rickb3n/EEG32/README.md

# EEG32
Rational board for medical EEG and ECG application, based on ESP32 and ADS1118 developed as part of a DIIIE UnivAQ Electronic Systems for Mechatronics course project

###### Development Team: *Riccardo Beniamino* , *Domenico Di Nicola*

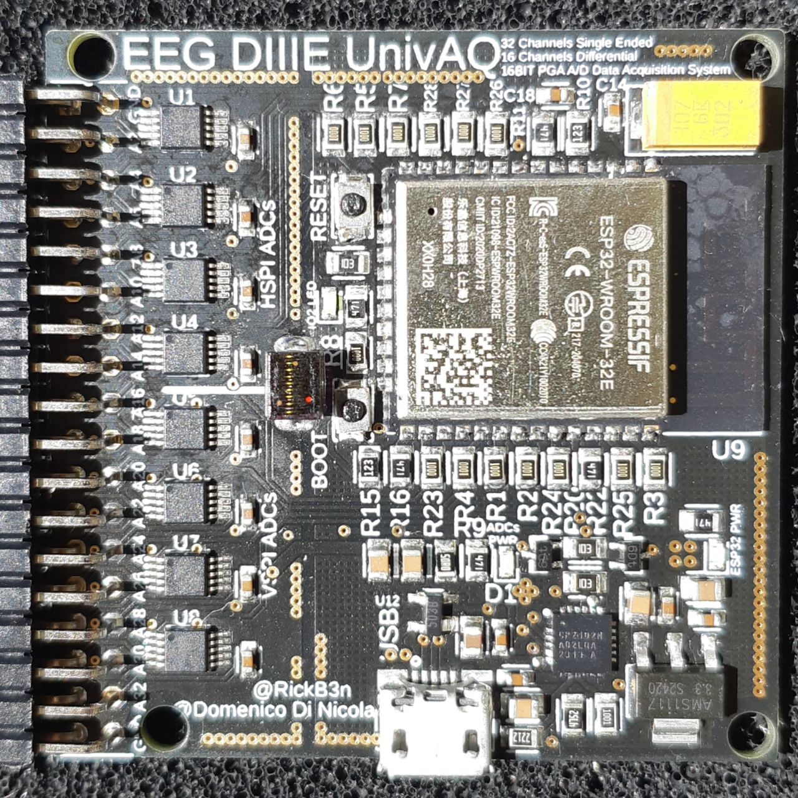
[picture p1: 1.jpg]

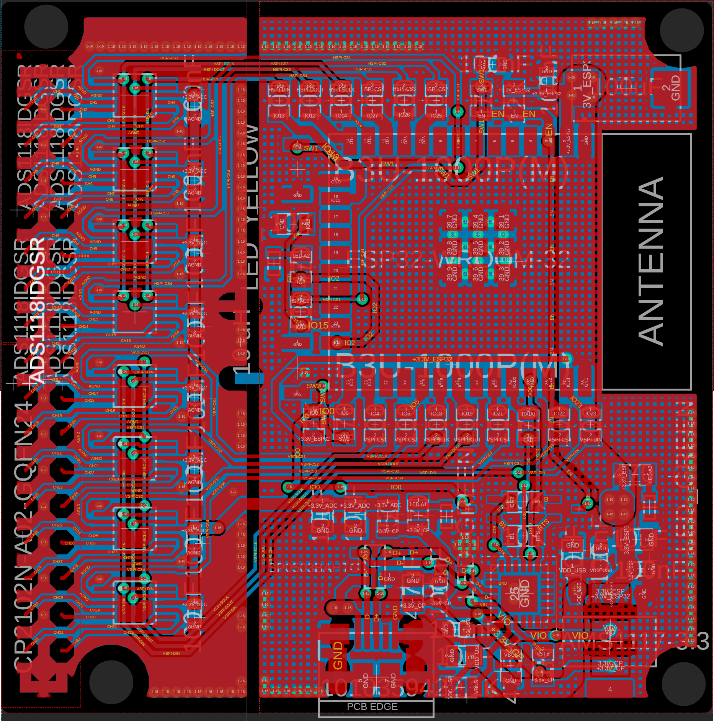
[picture p2: pcb_signals_names.png]

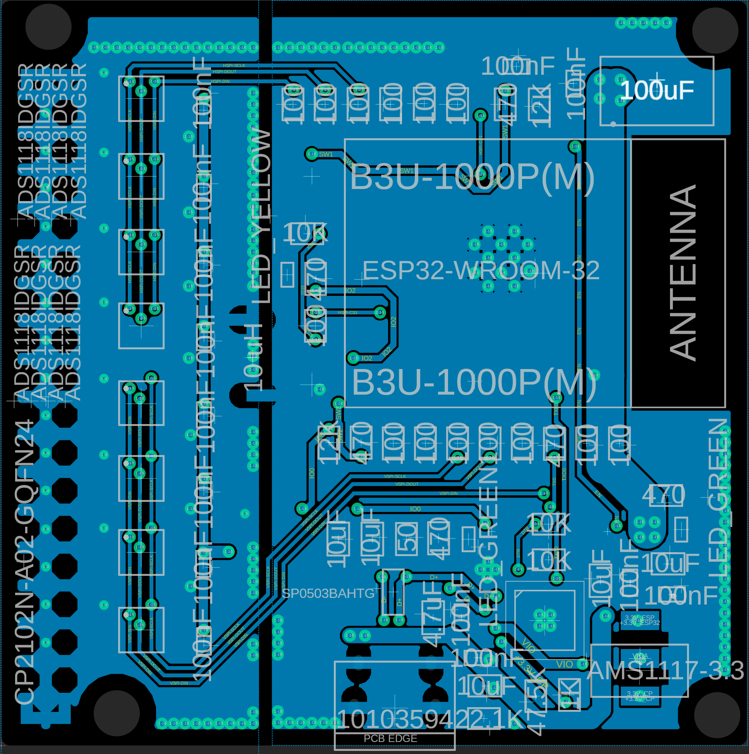
[picture p3: pcb_signals_names_back.png]
