rickb3n/EEG32/EEG32_Schematic.pdf

## ADC-CH1-4

## ADCS-CONTROLLED-BY-HSPI

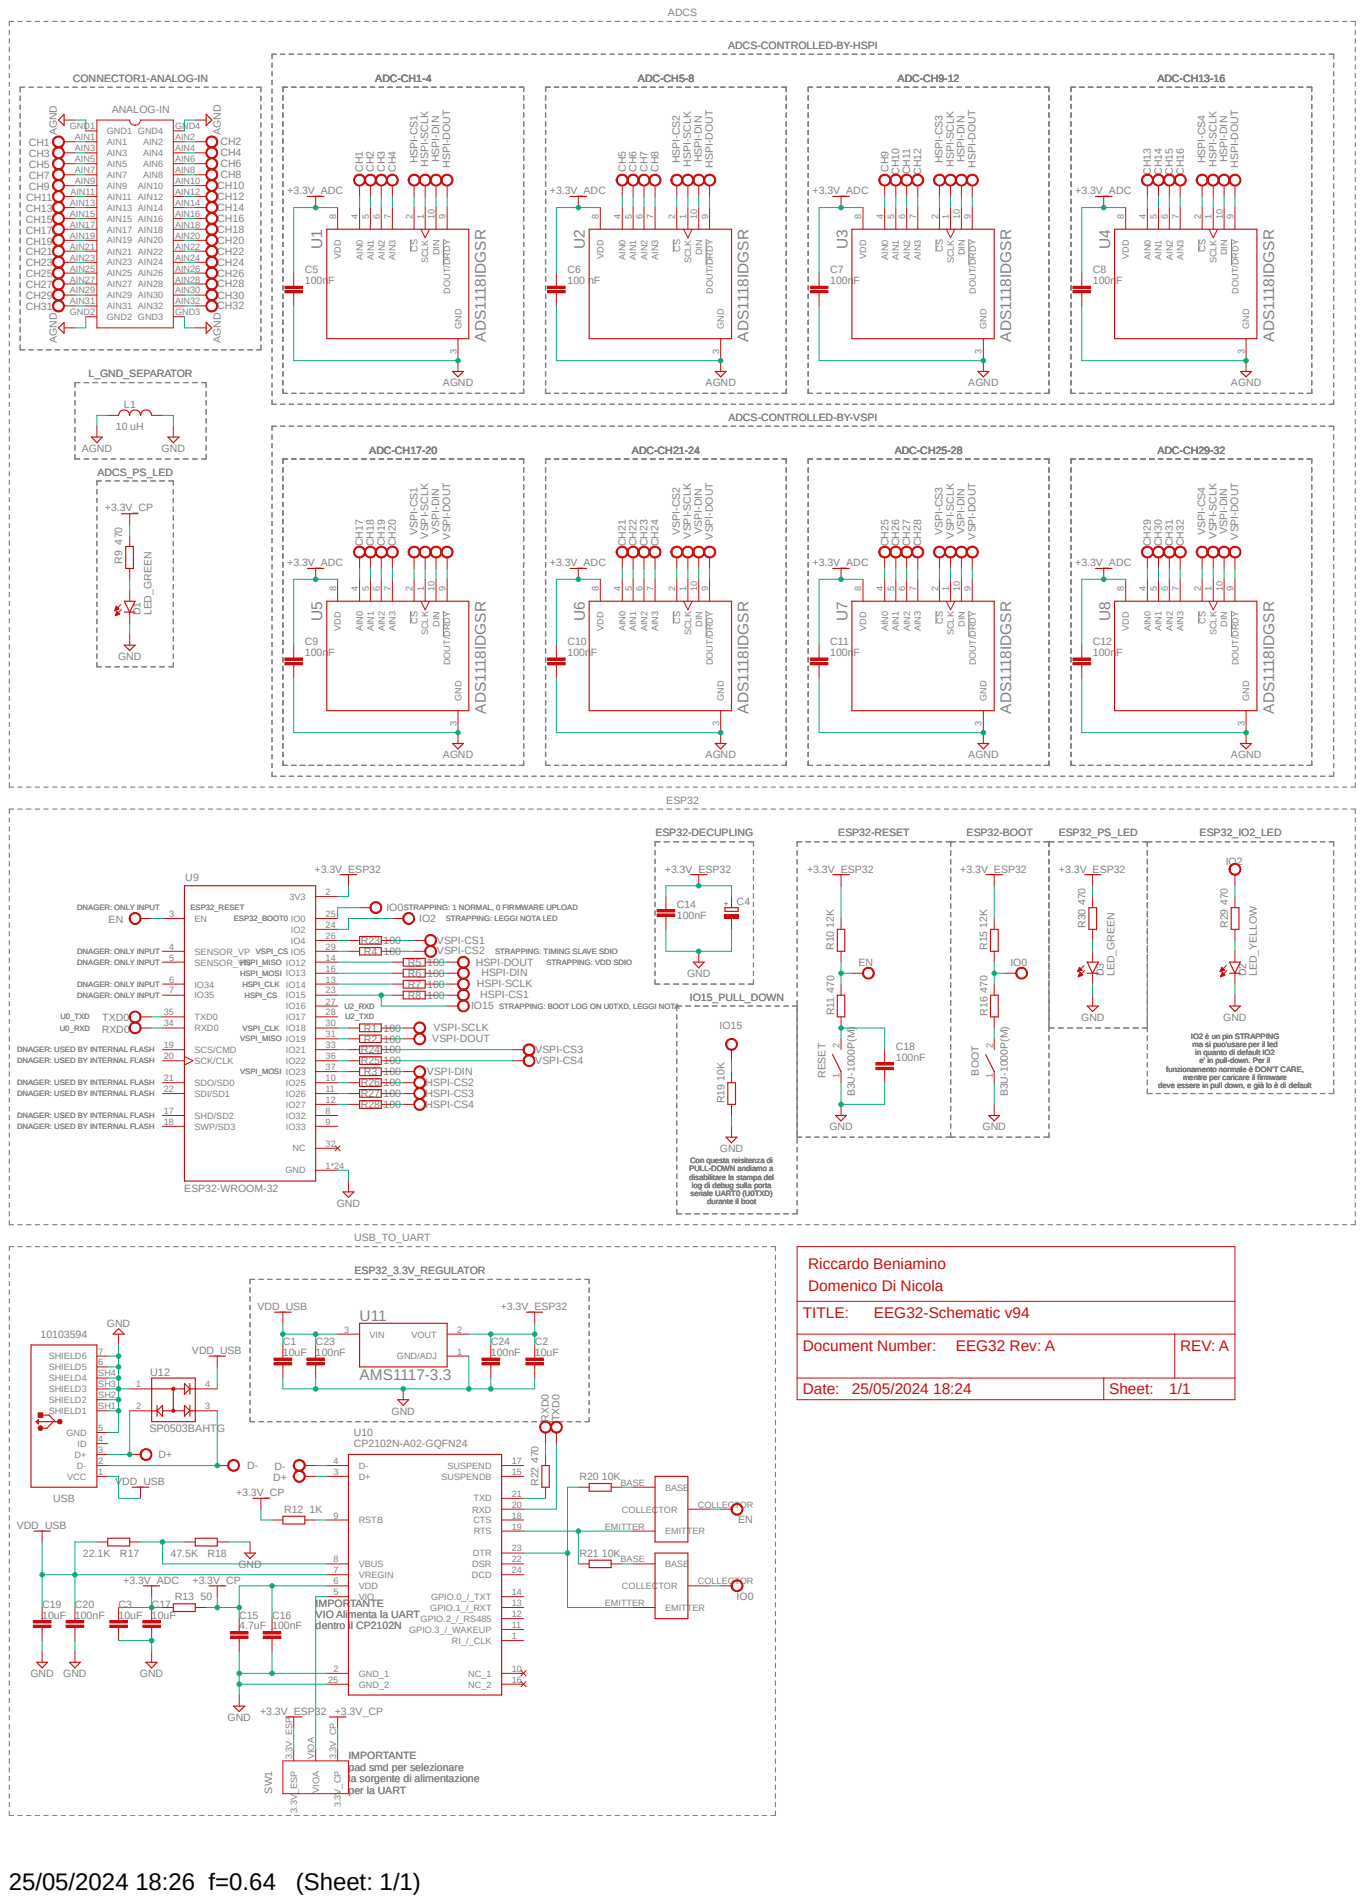
[picture p4: page 1]

ADCS-CONTROLLED-BY-HSPI

ADCS-CONTROLLED-BY-VSPI

STRAPPING: 1 NORMAL, 0 FIRMWARE UPLOAD

STRAPPING: LEGGI NOTA LED

STRAPPING: TIMING SLAVE SDIO
HSPI-DOUT
HSPI-DIN
HSPI-SCLK

STRAPPING: BOOT LOG ON U0TXD, LEGGI NOTA

DNAGER: USED BY INTERNAL FLASH

IO2 è un pin STRAPPING
ma si puo'usare per il led
in quanto di default IO2
e' in pull-down. Per il

funzionamento normale è DON'T CARE,
mentre per caricare il firmware
deve essere in pull down, e già lo è di default

Con questa reisitenza di
PULL-DOWN andiamo a
disabilitare la stampa del
log di debug sulla porta
seriale UART0 (U0TXD)
durante il boot

IMPORTANTE
VIO Alimenta la UART
dentro il CP2102N

pad smd per selezionare
la sorgente di alimentazione
per la UART
