rickb3n/EEG32/(commit log)

2024-07-01 Autodesk Fusion Project
    Complete Schematic, PCB and 3D project exported from Autodesk Fusion
2024-07-01 Final Schematic
2024-07-01 Gerber, BOM and CPL file for fabrication
2024-07-01 CPL file
    [PCB_v223_CPL6.csv]
2024-07-01 BOM file
    [PCB_v223_BOM.csv]
2024-07-01 Gerber file
2024-07-01 PCB front photo
2024-07-01 PCB signals names and paths
    Useful for hw debugging
2024-07-01 pcb signals names back
    useful for hw debugging
2024-07-05 Update 16_Channels_Differential_Read_Example_Code.ino
    Only 3 digits after the decimal point are printed. This leads to less overhead to the uart. It is useless to print figures that do not carry information content, disturbed by stochastic processes.
